iTeleTram/turnout_hw/assembly/Back_Assembly.pdf

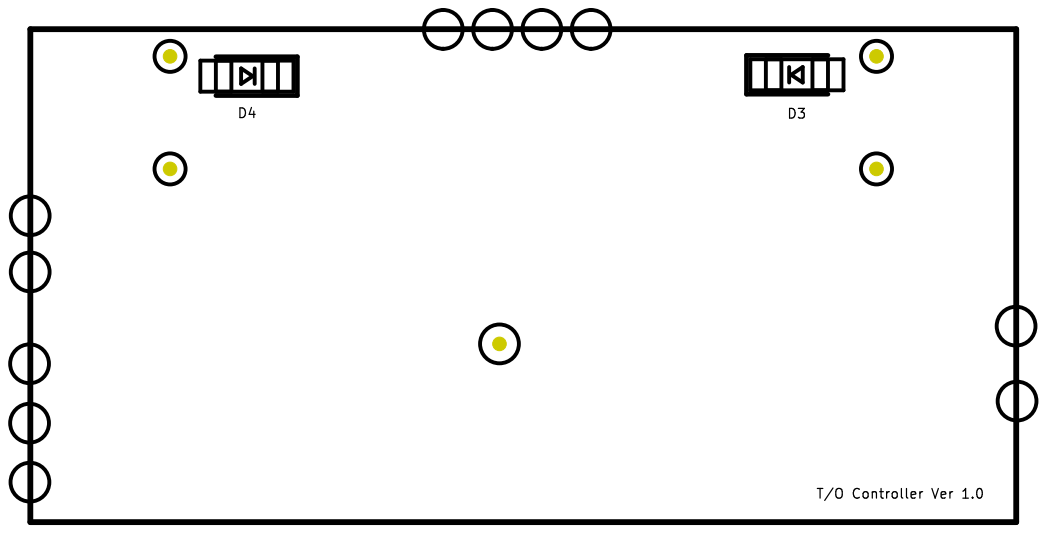
[picture p1: page 1]
