iTeleTram/turnout_hw/assembly/Front_Assembly.pdf

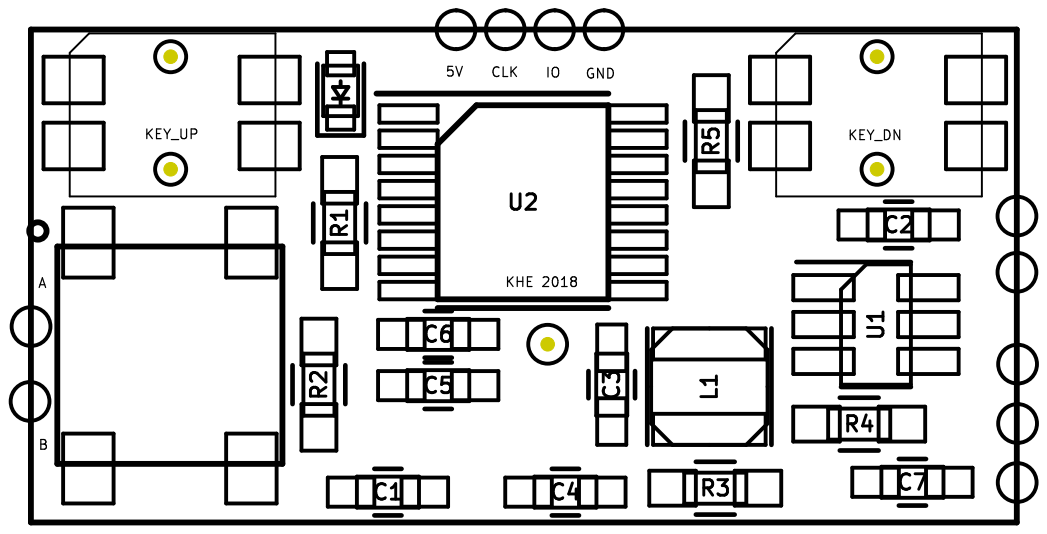
[picture p2: page 1]
