iTeleTram/turnout_hw/turnout_front.pdf

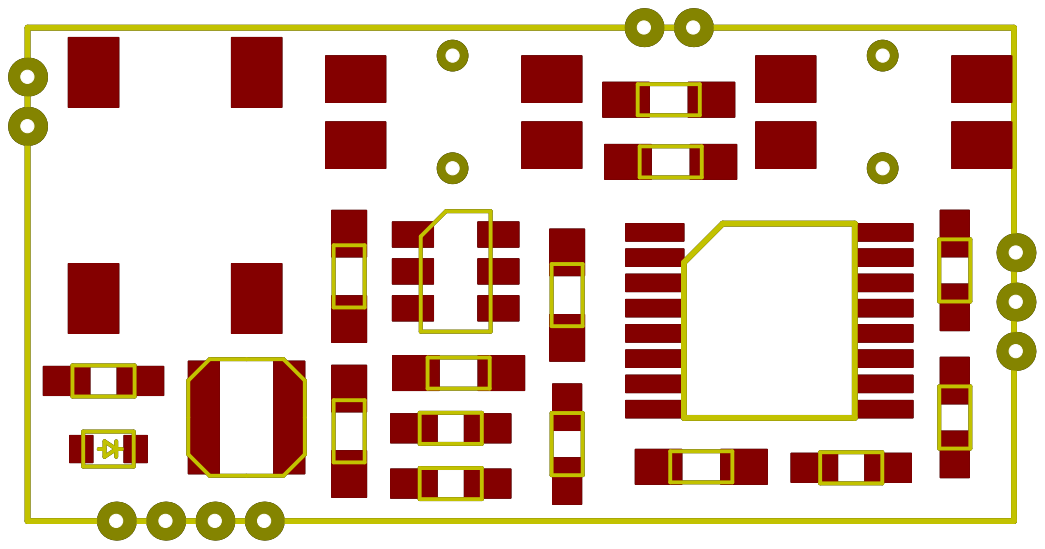
[picture p3: page 1]
