iTeleTram/turnout_hw/turnout_controller.kicad_pcb

## KiCad design turnout_controller.kicad_pcb (2018-10-31)

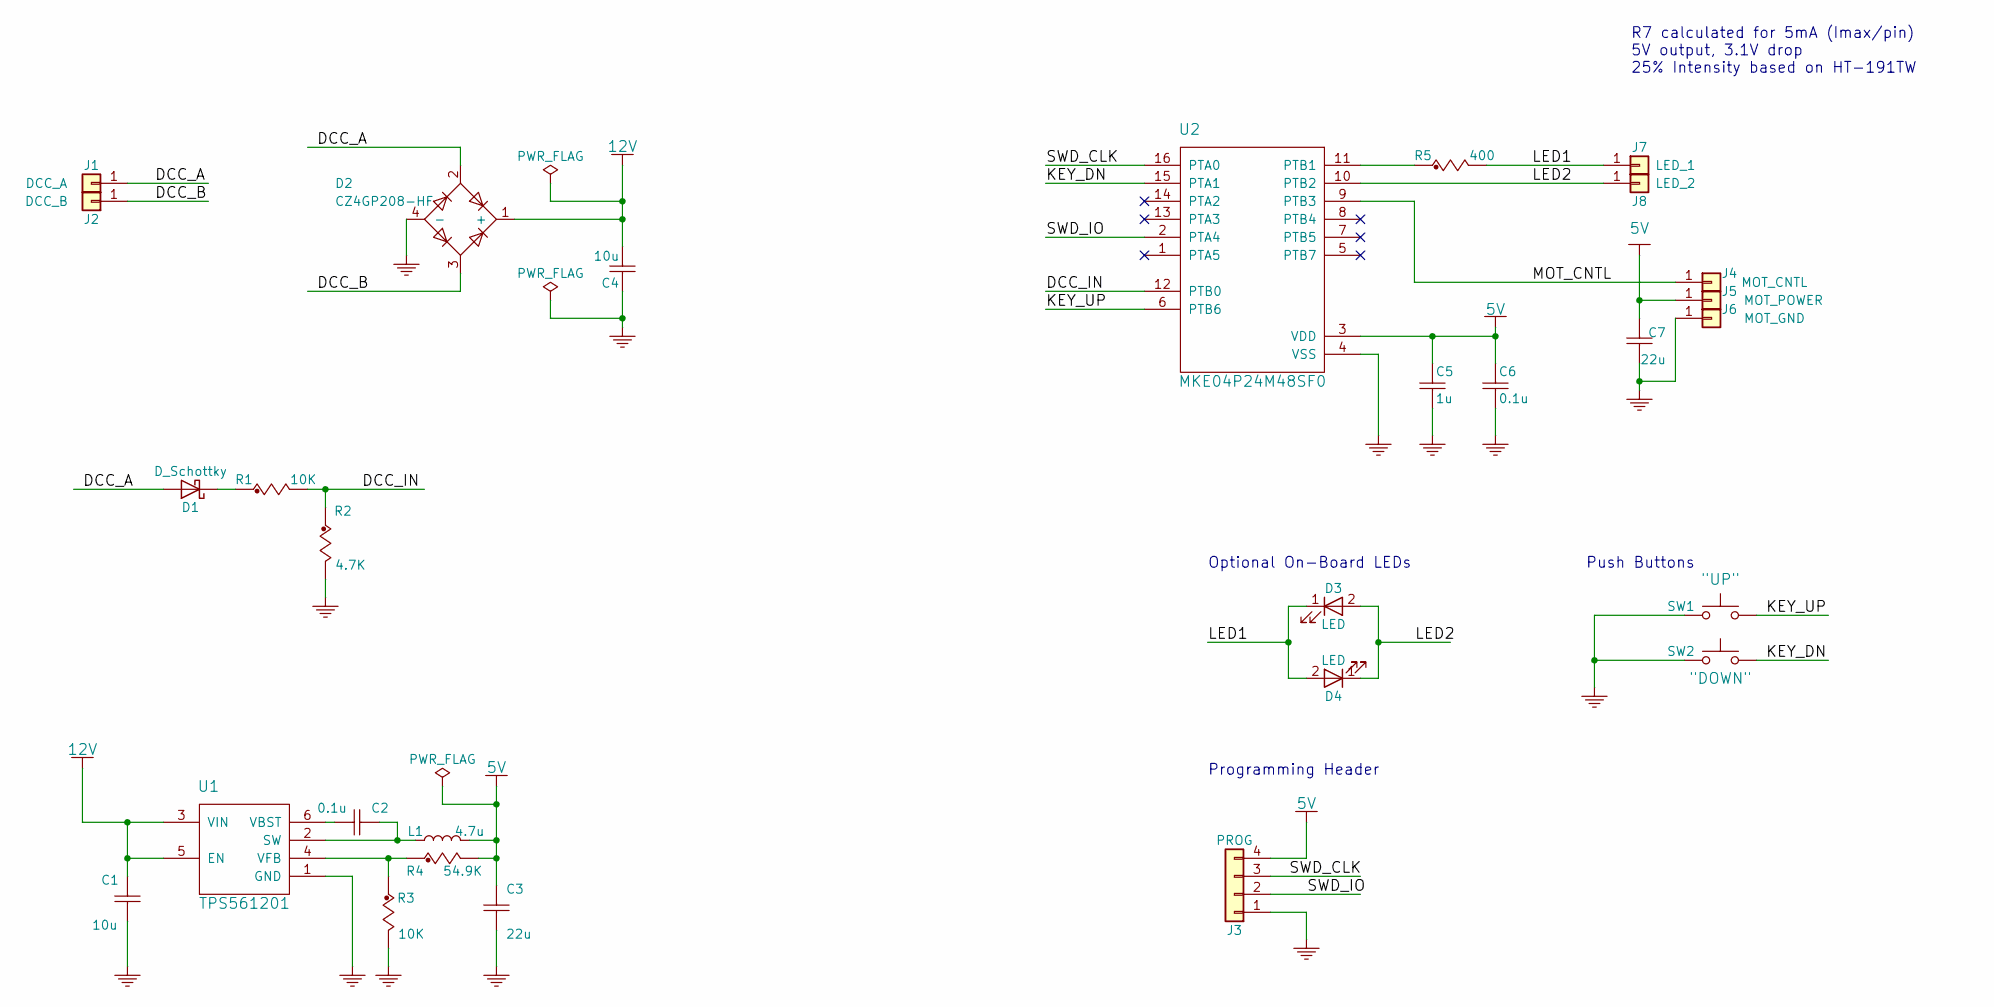
[picture p4: schematic turnout_controller.sch]

Parts:
C1, C4: 10u; C_0603_HandSoldering; Voltage 16; MFG P/N GRT188R61C106ME13D
C2: 0.1u; C_0603_HandSoldering; Voltage 10 VDC; MFG P/N VJ0603V104ZXQPW1BC
C3, C7: 22u; C_0603_HandSoldering; Voltage 6.3; MFG P/N GRT188R60J226ME13D
C5: 1u; C_0603_HandSoldering; Voltage 10; MFG P/N 885012106010
C6: 0.1u; C_0603_HandSoldering; Voltage 10; MFG P/N VJ0603V104ZXQPW1BC
D1: D_Schottky; D_SOD-523; MFG P/N PMEG2010AEB,115
D2: CZ4GP208-HF; Z4GP208-HF-SMD; MFG P/N Z4GP208-HF
D3, D4: LED; LED_0603; MFG P/N HT-191TW
J1: DCC_A; Socket_Strip_Straight_1x01_Pitch1.27mm_at_edge
J2: DCC_B; Socket_Strip_Straight_1x01_Pitch1.27mm_at_edge
J3: PROG; Socket_Strip_Straight_1x04_Pitch1.27mm_at_edge
J4: MOT_CNTL; Socket_Strip_Straight_1x01_Pitch1.27mm_at_edge
J5: MOT_POWER; Socket_Strip_Straight_1x01_Pitch1.27mm_at_edge
J6: MOT_GND; Socket_Strip_Straight_1x01_Pitch1.27mm_at_edge
J7: LED_1; Socket_Strip_Straight_1x01_Pitch1.27mm_at_edge
J8: LED_2; Socket_Strip_Straight_1x01_Pitch1.27mm_at_edge
L1: 4.7u; L_Taiyo-Yuden_NR-30xx; MFG P/N NRH3012T4R7MN
R1, R3: 10K; R_0603_HandSoldering; MFG P/N CRCW060310K0JNEAC
R2: 4.7K; R_0603_HandSoldering; MFG P/N CRCW06034K70JNEAC‎
R4: 54.9K; R_0603_HandSoldering; MFG P/N ERA-3AED5492V
R5: 400; R_0603_HandSoldering; MFG P/N PAT0603E4000BST1
SW1: SW_Push; HTB1-Button; MFG P/N TS-1289VE-4
SW2: SW_Push; HTB1-Button
U1: TPS561201; SOT-23-6_Handsoldering; MFG P/N TPS561201DDCR
U2: MKE04P24M48SF0; TSSOP-16_4.4x5mm_Pitch0.65mm; MFG P/N MKE04P24M48SF0

Connections:
5V: C3.2, C5.2, C6.2, C7.1, J3.4, J5.1, L1.2, R4.2, U2.3 (VDD)
12V: C1.2, C4.1, D2.1 (+), U1.3 (VIN), U1.5 (EN)
/DCC_A: D1.2 (A), D2.2, J1.1
/DCC_B: D2.3, J2.1
/DCC_IN: R1.2, R2.1, U2.12 (PTB0)
/KEY_DN: SW2.2, U2.15 (PTA1)
/KEY_UP: SW1.2, U2.6 (PTB6)
/LED1: D3.1 (K), D4.2 (A), J7.1, R5.2
/LED2: D3.2 (A), D4.1 (K), J8.1, U2.10 (PTB2)
/MOT_CNTL: J4.1, U2.9 (PTB3)
/SWD_CLK: J3.3, U2.16 (PTA0)
/SWD_IO: J3.2, U2.2 (PTA4)
GND: C1.1, C3.1, C4.2, C5.1, C6.1, C7.2, D2.4 (-), J3.1, J6.1, R2.2, R3.2, SW1.1, SW2.1, U1.1 (GND), U2.4 (VSS)
unnamed: C2.1, U1.6 (VBST)
unnamed: C2.2, L1.1, U1.2 (SW)
unnamed: D1.1 (K), R1.1
unnamed: R3.1, R4.1, U1.4 (VFB)
unnamed: R5.1, U2.11 (PTB1)

Notes on the sheet:
R7 calculated for 5mA (Imax/pin) 5V output, 3.1V drop 25% Intensity based on HT-191TW
Optional On-Board LEDs
Push Buttons
Programming Header

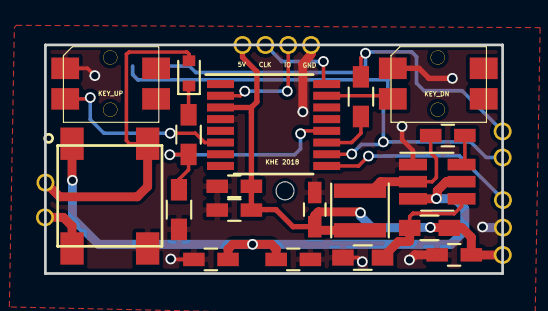
[picture p5: board turnout_controller.kicad_pcb from above]

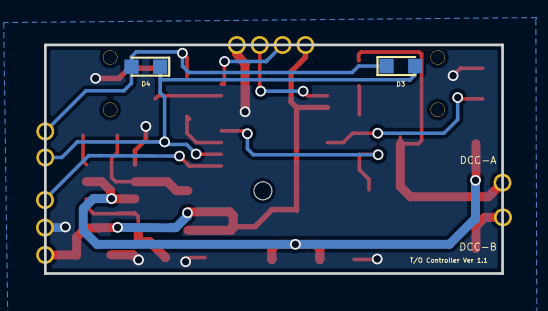
[picture p6: board turnout_controller.kicad_pcb from below]

Board: 2 copper layers, 25.4 x 12.7 mm, 29 parts (2 on the bottom side), 18 nets.
