iTeleTram/turnout_hw/(commit log)

2017-11-22 Initial upload of turnout circuit
    [turnout_controller.kicad_pcb, turnout_controller.sch]
2017-11-27 Version 2: Passive components not yet defined.
    [turnout_controller.sch]
2017-11-27 changed pushbuttons connectivity
    [turnout_controller.sch]
2017-11-29 Corrected LED Resistor value and added note. Rearranged schematic
    [turnout_controller.sch]
2018-01-03 Updated turnout controller
    [turnout_controller.sch]
2018-02-27 Includes:
    New project file
    Footprints for buttons, bridge rectifier and edge connectors
    initial circuit board layout
    [turnout_controller.kicad_pcb, turnout_controller.sch]
2018-03-11 1. New PCB layout based around new positioning of buttons.
    2. Optimizing distance between buck circuit components.
    3. Added optional on-board LEDs.
    [turnout_controller.kicad_pcb, turnout_controller.sch]
2018-03-19 updated PCB layout
    [turnout_controller.kicad_pcb, turnout_controller.sch]
2018-03-20 Updated PCB layout. Re-arrange buck, and added mounting hole
    [turnout_controller.kicad_pcb]
2018-03-23 Connector improvements. Initial trace layout.
    [turnout_controller.kicad_pcb, turnout_controller.sch]
2018-03-27 First layout. Connections routed. Ground fill remains.
    [turnout_controller.kicad_pcb]
2018-03-28 DRC fixes (via moved, trace modified. No GND connections.
2018-04-26 Updated PCB layout w/fill zones. Requires mouting hole and pads
    [turnout_controller.kicad_pcb]
2018-05-10 PCB updated with better copper pours, mounting hole and soldering pads
    [turnout_controller.kicad_pcb]
2018-06-25 Circuit updated with TPS561201 buck
    [turnout_controller.kicad_pcb, turnout_controller.sch]
2018-06-25 Circuit updated with TPS561201 buck-bug fix C4 value to .1u
    [turnout_controller.sch]
2018-07-07 New PCB layout
    [_saved_turnout_controller.sch, old_tc.kicad_pcb, turnout_controller.kicad_pcb]
2018-07-07 to be verified
    [turnout_controller.kicad_pcb]
2018-07-09 alternate PCB 2
    [turnout_controller.op2.kicad_pcb, turnout_controller_op1.kicad_pcb]
2018-07-10 TPS561201 Revision 2
    [turnout_controller.kicad_pcb]
2018-07-10 TPS561201 - final board for review
    [turnout_controller.kicad_pcb]
2018-07-10 TPS561201 - final board for review - added mounting pads
    [turnout_controller.kicad_pcb]
2018-07-15 Holes replaced with via part using proper via sitching techniques.
    [turnout_controller.kicad_pcb]
2018-07-15 Via updated with solid connection
    [turnout_controller.kicad_pcb]
2018-07-23 Board revision 3.0 - prog header @ top
    [turnout_controller.kicad_pcb, turnout_controller.sch, turnout_controller_old.kicad_pcb]
2018-07-29 Fix LED2 via acute angle issue
    [turnout_controller.kicad_pcb]
2018-07-29 File cleanup
    [turnout_controller.kicad_pcb]
2018-08-02 Silk Screen update. Final change before production
    [turnout_controller.kicad_pcb]
2018-08-02 Submitted for production
    [turnout_controller-B.Cu.gbr, turnout_controller-B.Mask.gbr, turnout_controller-B.SilkS.gbr, turnout_controller-Edge.Cuts.gbr, turnout_controller-F.Cu.gbr, turnout_controller-F.Mask.gbr, turnout_controller-F.SilkS.gbr, turnout_controller-NPTH.drl]
2018-08-06 Updated schematic for clarity. New Netlist. No PCB changes.
    [turnout_controller.kicad_pcb, turnout_controller.sch]
2018-08-17 Added component part numbers (including passives) and BOM.
    [turnout_controller.sch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]
2018-10-30 Updated schematics and board layout to fix LED issue
    [turnout_controller.kicad_pcb, turnout_controller.sch]
2018-10-31 Modified DCC-IN trace to respect 0.25mm clearance requirements from mfg
    [turnout_controller-B.Cu.gbr, turnout_controller-B.Mask.gbr, turnout_controller-B.SilkS.gbr, turnout_controller-Edge.Cuts.gbr, turnout_controller-F.Cu.gbr, turnout_controller-F.Mask.gbr, turnout_controller-F.SilkS.gbr, turnout_controller-NPTH.drl]
